ziocha/piezomodel1/README.md

# 27 mm PZT 유니모프 벤더 디스크 CAD 모델

## 파일

| 파일 | 용도 |
| --- | --- |
| `disc_assembly.stl` | 실척 조립 모델. 타일 하우징 설계 시 이 파일을 불러와 간섭 확인 |
| `disc_01_brass.stl` | 황동 백킹판 Ø27.0 × t0.30 |
| `disc_02_ceramic.stl` | PZT 세라믹층 Ø19.7 × t0.22 |
| `disc_03_electrode.stl` | 은 전극 Ø18.5 × t0.02 |
| `disc_04_leads.stl` | 납땜 패드 2개 + 리드선 (각 12 mm만 모델링) |
| `disc_cutaway_x10.stl` | 발표용 반단면 모델. **두께만 10배 과장**했으므로 설계에 쓰면 안 됨 |
| `disc_section_drawing.png` | 보고서용 단면도 |
| `piezo_disc_model.py` | 생성 스크립트. 치수 상수만 바꿔 다시 실행하면 전부 재생성 |

조립 모델 외곽 치수: 37.5 × 27.0 × 1.065 mm (리드선 포함)
디스크 본체만: Ø27.0 × t0.54 mm

## 치수 출처

Murata 7BB-27-4 데이터시트 **공칭값**이다. 실측값이 아니다.

- 외경 27.0 mm / 세라믹 19.7 mm / 총 두께 0.54 mm
- 공진 4.6 ± 0.5 kHz, 정전용량 20 nF ± 30 %

황동판 0.30 mm와 세라믹 0.22 mm의 배분, 전극 두께 0.02 mm는 총 두께에서
역산한 값이므로 오차가 있을 수 있다. 하우징 설계 전에 캘리퍼스로
**외경·세라믹 지름·총 두께 세 가지**를 재서 `piezo_disc_model.py`의
상수를 고친 뒤 다시 생성할 것.

우리 디스크의 실측 공진은 3,332 Hz로 데이터시트보다 약 1 kHz 낮다.
바닥에 놓고 친 지지 조건 차이로 보지만, 소자 자체가 7BB-27-4가 아닐
가능성도 남아 있다. 치수가 위 값과 다르면 그쪽이 원인이다.

## 하우징 설계 시 주의

1. **테두리만 지지할 것.** 유니모프 벤더는 가운데가 휘어야 전하가 난다.
   디스크 전면을 받치면 굽힘이 막혀 출력이 크게 줄어든다.
   하우징에는 Ø27 자리를 파고, 바깥 1~2 mm 링만 닿게 한다.
2. **중앙 공간 확보.** 디스크 아래에 최소 0.5 mm 이상 빈 공간을 둔다.
3. **리드선 통로.** 모델의 리드선은 +x 방향 12 mm만 그려져 있다.
   실물은 70~100 mm이므로 하우징 측면에 Ø1.5 이상 배선 홈이 필요하다.
4. 납땜 패드가 상면에서 1.6 mm 가량 솟아 있다(도면상 고정 높이).
   상판이 이 부분을 누르지 않도록 도피 홈을 판다.

## 재생성

```bash
pip install trimesh manifold3d
python3 piezo_disc_model.py      # STL 6개
python3 section_drawing.py       # 단면도 PNG
```
