ziocha/piezomodel1/README_JIG.md

# 27 mm PZT 디스크 실험 지그

유리프 압전 타일 팀 / 2026-10-21

P–R 곡선 측정과 소자 3종 비교에 필요한 **가압 조건 고정**을 위한 지그다.
손으로 누른 4회의 CV 6.9 %는 잘 나온 쪽이고, 조건당 10회를 다른 날
재면 그 재현성이 유지되지 않는다. 가한 힘의 절대값도 모른다.

## 파일

| 파일 | 내용 |
| --- | --- |
| `jig_01_base.stl` | 하판 44 × 44 × 6 |
| `jig_02_plunger.stl` | 가압 플런저 Ø27 × 24 |
| `jig_03_guide_tube.stl` | 낙하추 가이드관 44 × 44 × 100 |
| `jig_00_assembly_check.stl` | 조립 확인용 (출력하지 말 것) |
| `jig_section_full.png` | 전체 단면도 |
| `jig_section_zoom.png` | 디스크 안착부 확대 단면 |
| `piezo_jig.py` | 생성 스크립트 |

## 설계 의도

**하판** — 포켓 Ø27.4 × 깊이 2.0에 디스크를 넣고, 중앙 Ø22를 관통시켜
비웠다. 디스크는 반경 11~13.7 mm의 링 2.7 mm 폭으로만 지지된다.
유니모프 벤더는 가운데가 휘어야 전하가 나므로 전면 지지는 금물이다.
포켓 바닥 높이에 5 × 1.2 배선 홈이 +x 방향으로 뚫려 있다.

**플런저** — 두 곳이 동시에 닿는다.

- 바깥 링(Ø24~27)이 황동 테두리를 눌러 경계조건을 고정한다
- 중앙 돌기(Ø9)가 세라믹 중앙을 누른다

세라믹이 황동보다 0.24 mm 높으므로 **돌기 바닥이 링 바닥보다 0.24 mm
위에 있다.** 이게 이 부품의 핵심 치수다. FDM 공차(±0.2 mm)와 거의
같은 크기라, 출력 후 두 접촉면이 동시에 닿는지 반드시 확인할 것.
안 닿으면 종이 한 장(약 0.1 mm)으로 조정한다.

링은 +x 쪽이 14 mm 폭으로 끊겨 있다. 황동판 위 납땜 패드(반경 12 mm)를
피하기 위한 슬롯이다. 실물 납땜 위치가 다르면 `R_SOLDER`를 고친다.

**가이드관** — 내경 Ø12.4로 Ø12 추(강봉 또는 M10 너트 적층)를 안내한다.
플랜지 밑면에 Ø28 × 5 도피 공간이 있어 플런저 몸통과 간섭하지 않는다.
옆면 6 mm 슬롯으로 추 위치를 보고 낙하 높이를 맞춘다.
스템 상단이 z ≈ 28 mm, 관 상단이 z ≈ 106 mm이므로 **낙하 높이는 0~77 mm**.

## 조립

1. 하판 포켓에 디스크를 넣고 리드선을 배선 홈으로 뺀다
2. 플런저를 포켓에 얹는다 (고정하지 않는다 — 자중으로만 놓임)
3. 가이드관을 하판 위에 올리고 M3 × 20 볼트 4개로 조인다
4. 추를 관에 넣고 정해진 높이에서 손을 뗀다

## 출력 설정

- 재료 PLA, 레이어 0.2 mm, 인필 40 % 이상
- 하판·플런저는 **포켓 면이 위를 향하게** 놓는다 (접촉면 정밀도 확보)
- 가이드관은 세워서 출력하고 브림을 넣는다
- 서포트: 가이드관 플랜지 도피 공간에만 필요

## 측정할 때

낙하 에너지는 `E = mgh`로 바로 계산되지만(50 g을 50 mm에서 = 25 mJ),
**충돌 피크 힘은 접촉 시간에 좌우되므로 이 지그로는 알 수 없다.**
힘의 절대값이 필요하면 로드셀을 넣어야 한다.

이 지그가 보장하는 것은 **같은 입력을 반복할 수 있다는 것**뿐이다.
그것만으로 부하 저항 변인과 소자 변인 비교는 성립한다. 보고서에는
"가한 힘 F"가 아니라 "낙하 에너지 mgh"를 조작변인으로 적을 것.
