ziocha/piezomodel1/disc_section_drawing.png

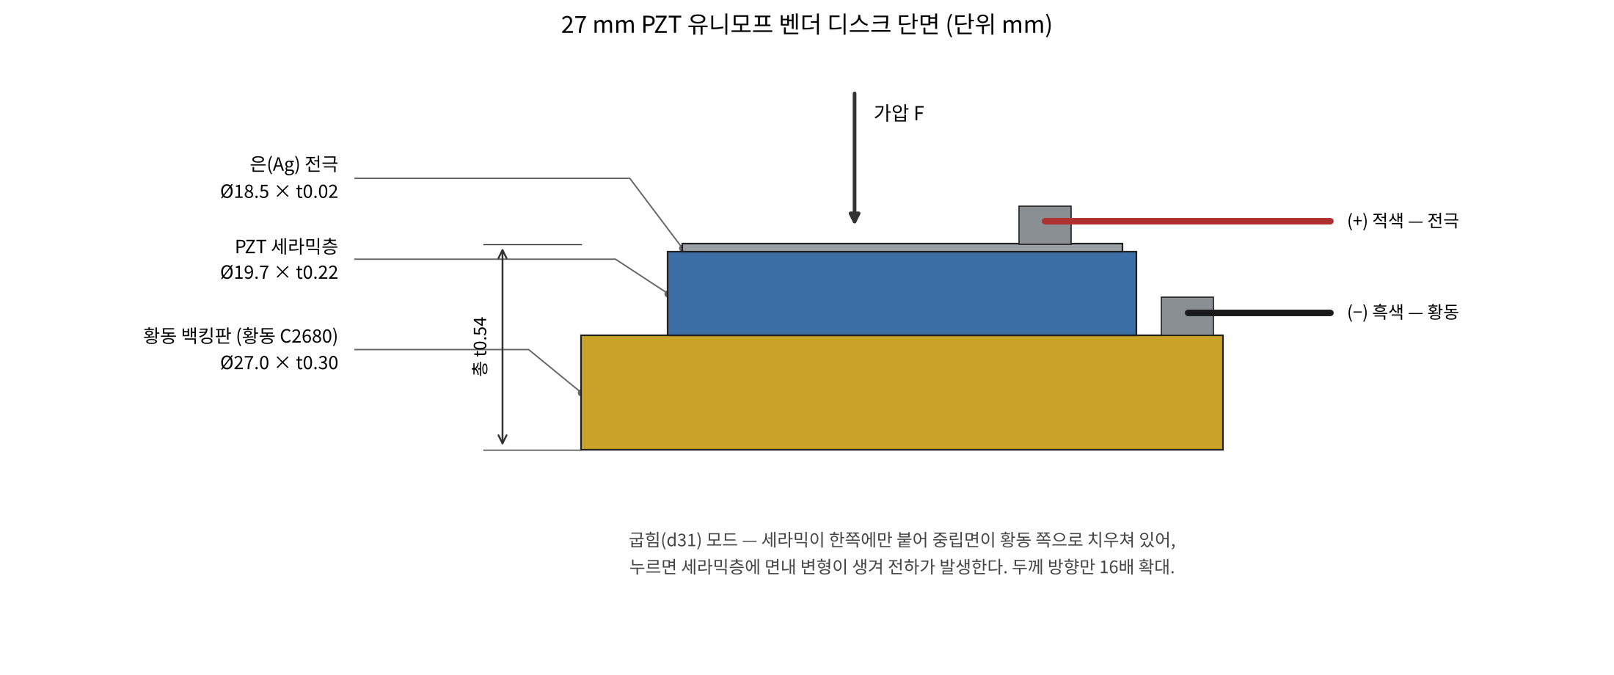
disc_section_drawing.png
