ziocha/piezomodel1/jig2_section.png

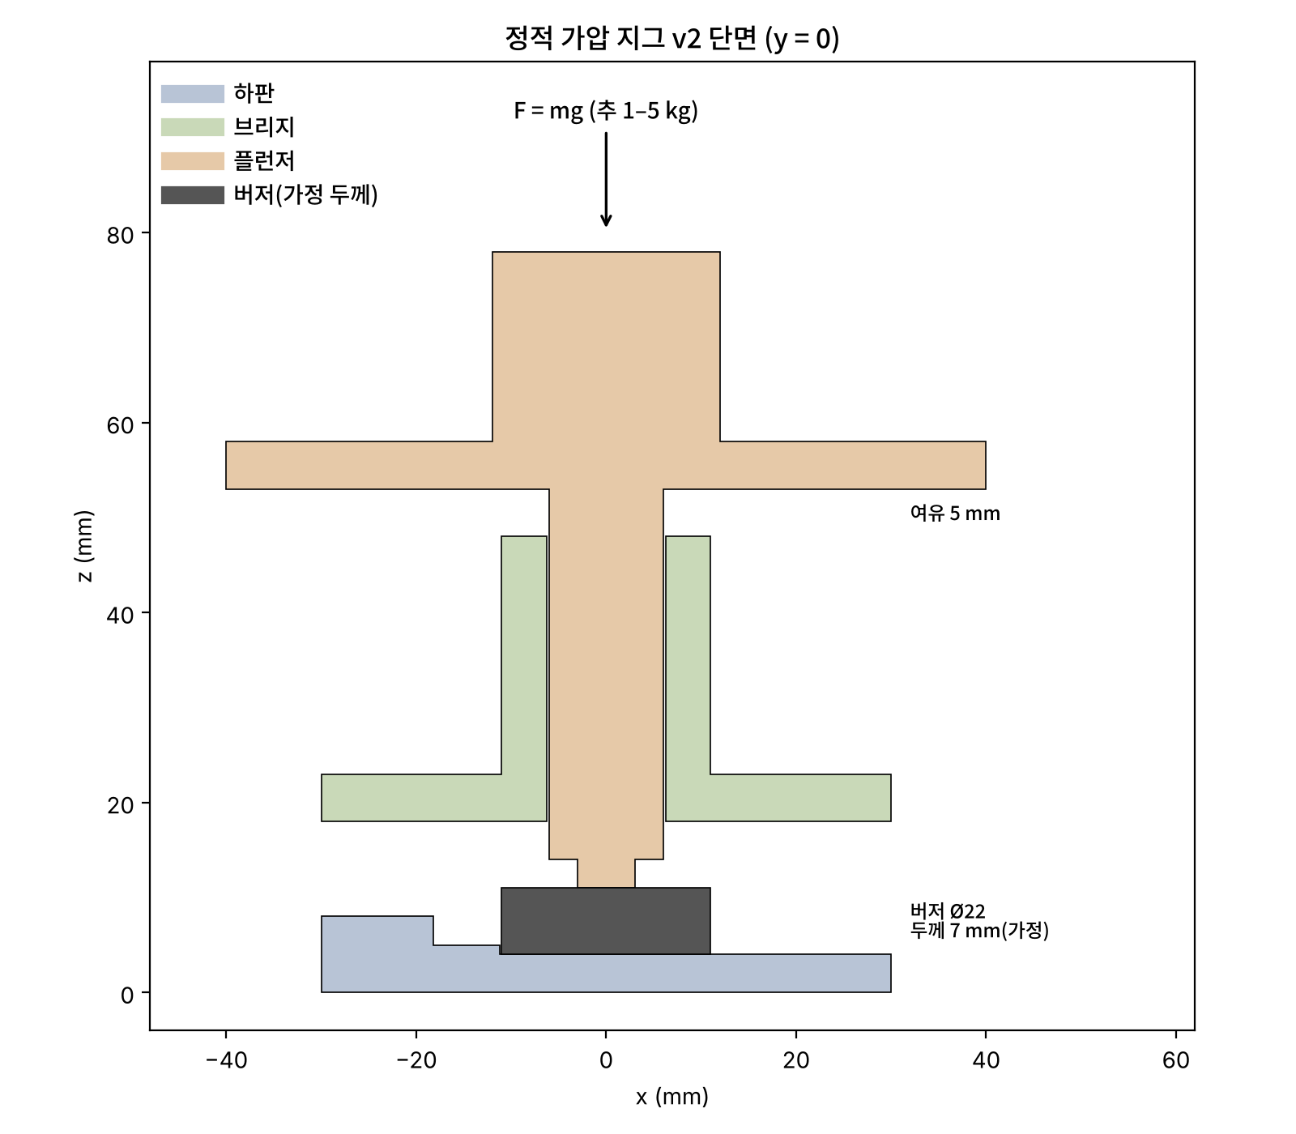
jig2_section.png
