ziocha/piezomodel1/jig_section_full.png

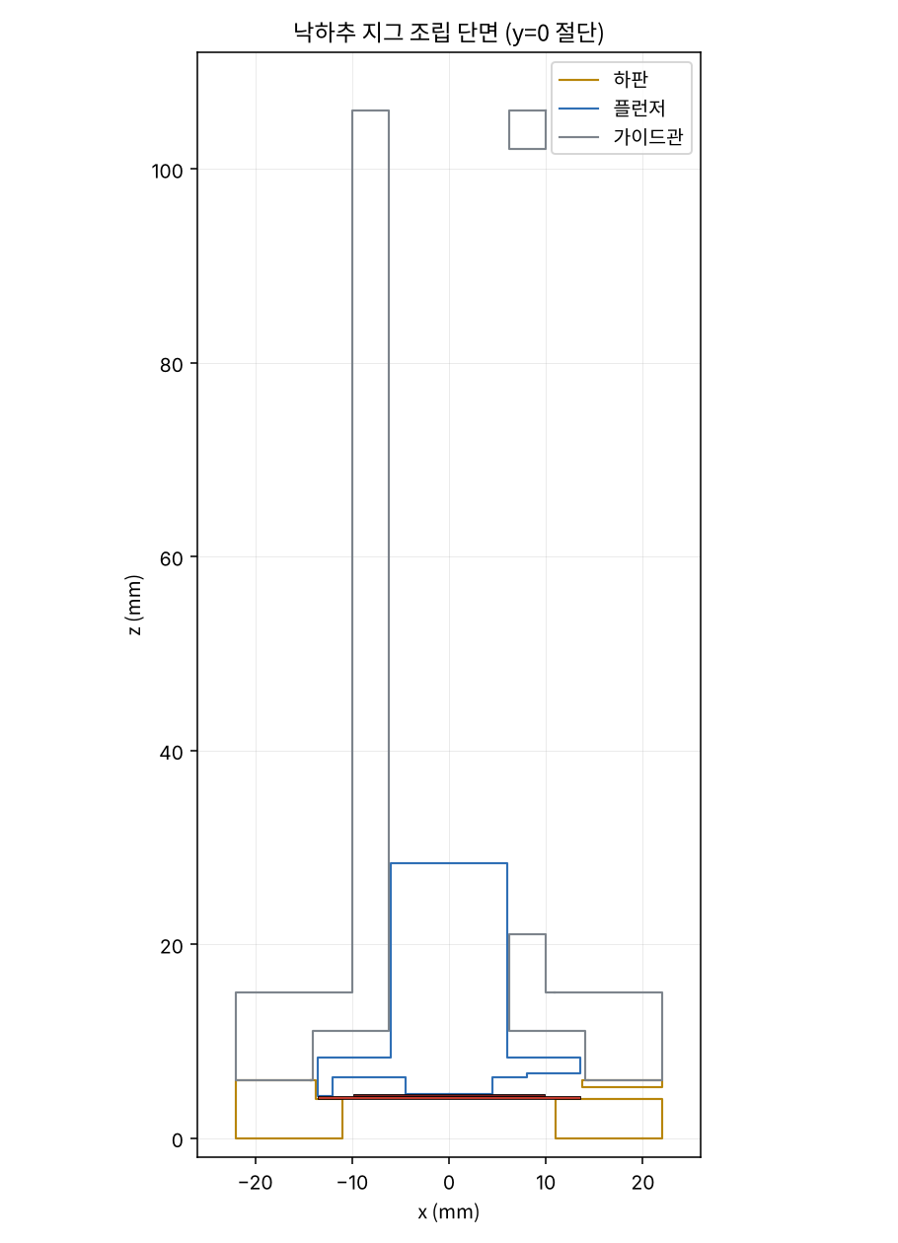
jig_section_full.png
