ziocha/piezomodel1/jig_section_zoom.png

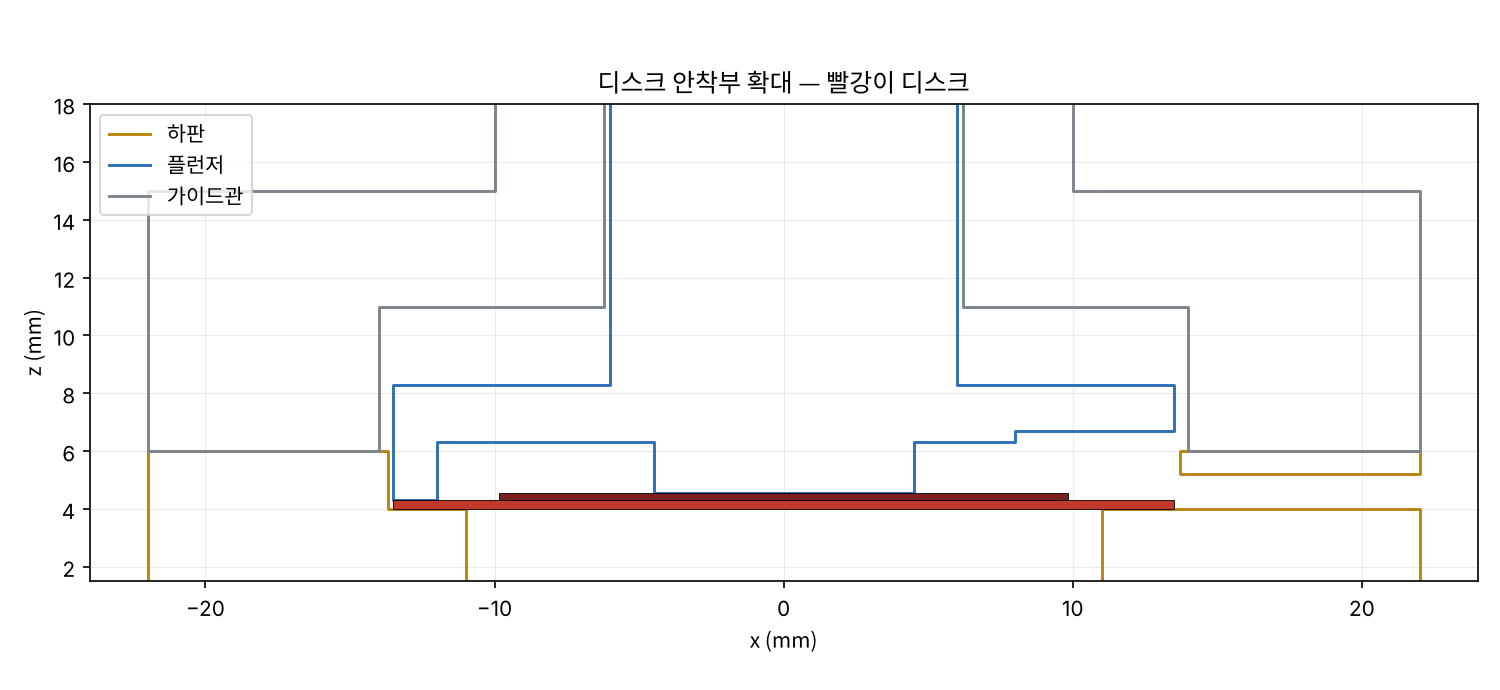
jig_section_zoom.png
