ziocha/piezomodel1/jig2_00_assembly_check.stl

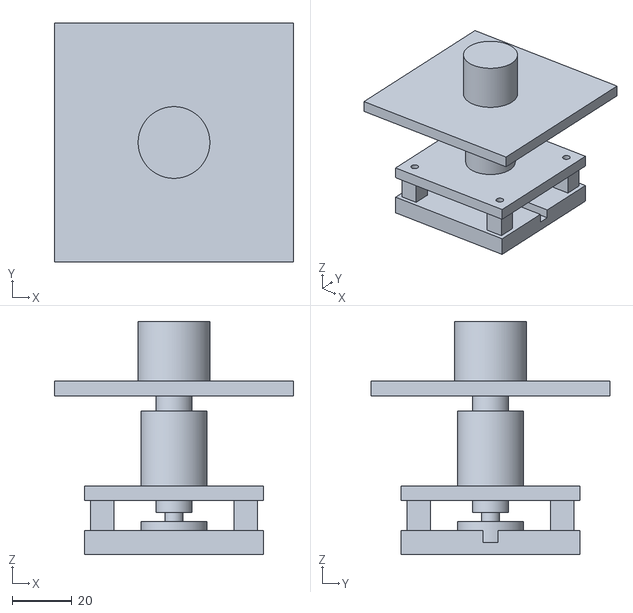
[picture p5: CAD file, 2026-10-28]
jig2_00_assembly_check.stl
80.0 x 80.0 x 78.0
