ziocha/piezomodel1/jig_00_assembly_check.stl

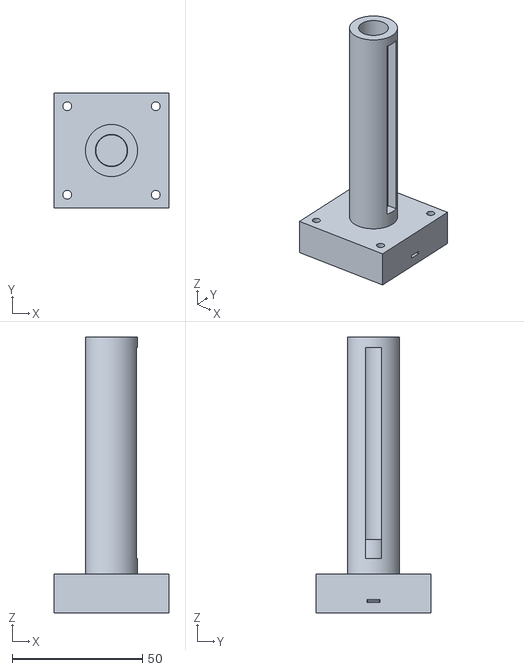
[picture p6: CAD file, 2026-10-21]
jig_00_assembly_check.stl
44.0 x 44.0 x 106.0
