ziocha/piezomodel1/disc_assembly.stl

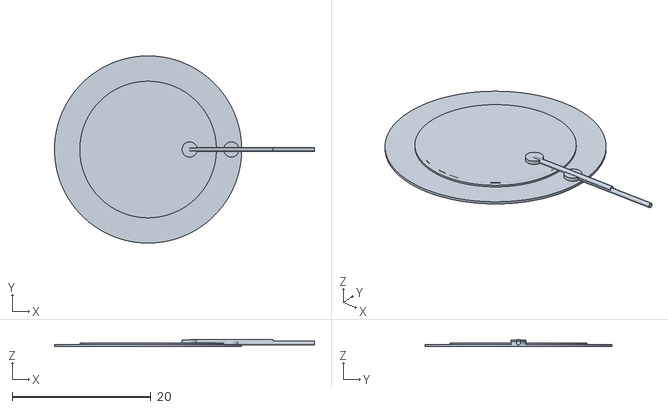
[picture p7: CAD file, 2026-10-21]
disc_assembly.stl
37.5 x 27.0 x 1.07
