ziocha/piezomodel1/jig2_02_bridge.stl

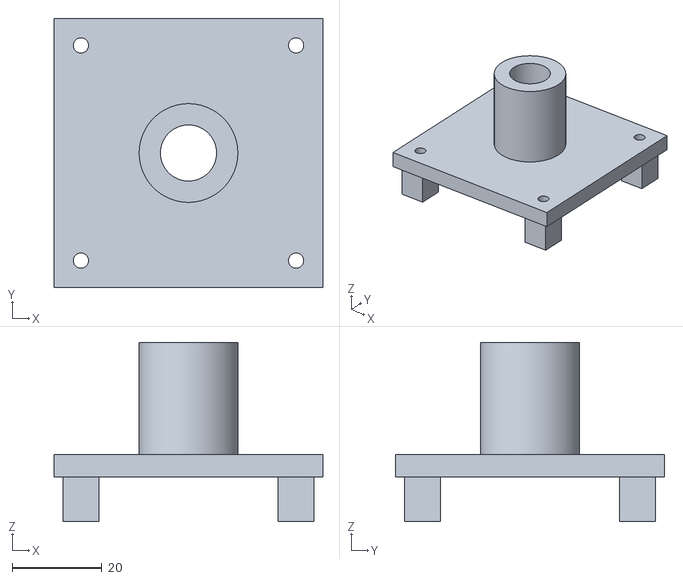
[picture p8: CAD file, 2026-10-28]
jig2_02_bridge.stl
60.0 x 60.0 x 40.0
