ziocha/piezomodel1/jig2_03_plunger.stl

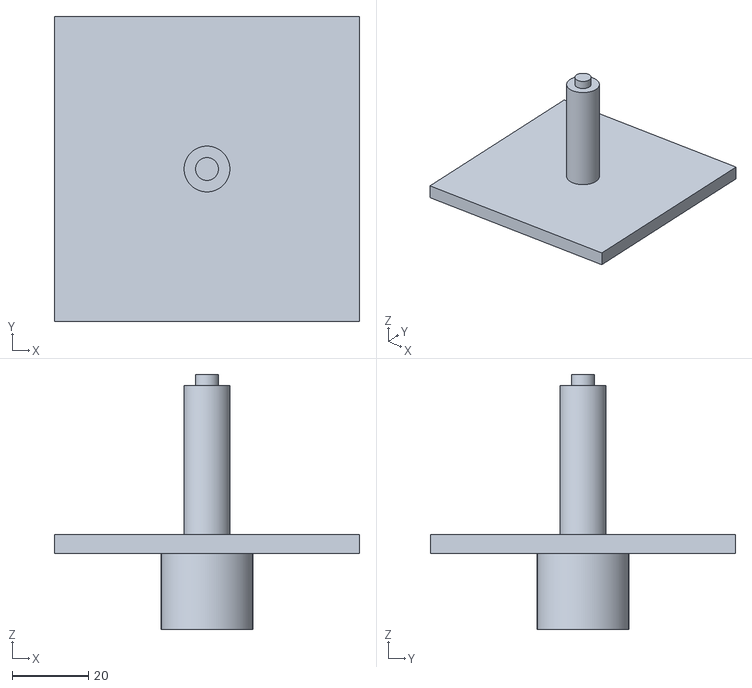
[picture p9: CAD file, 2026-10-28]
jig2_03_plunger.stl
80.0 x 80.0 x 67.0
