ziocha/piezomodel1/jig2_01_base.stl

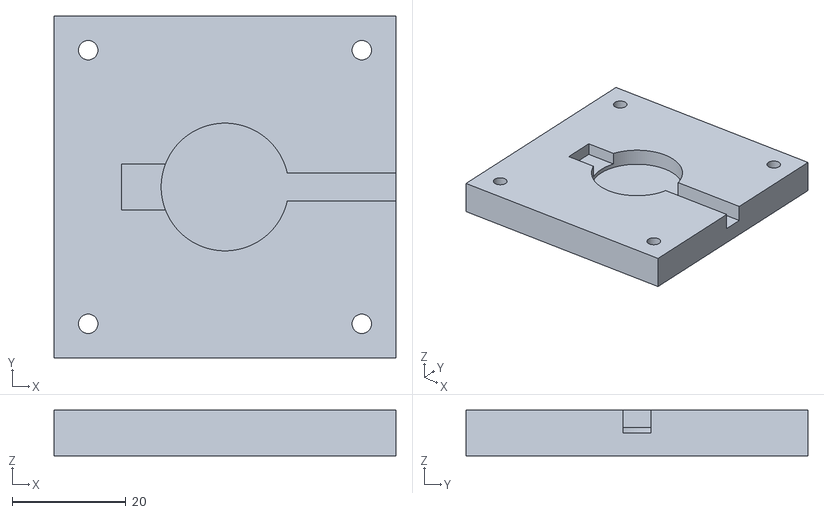
[picture p10: CAD file, 2026-10-28]
jig2_01_base.stl
60.0 x 60.0 x 8.00
