ziocha/piezomodel1/jig_01_base.stl

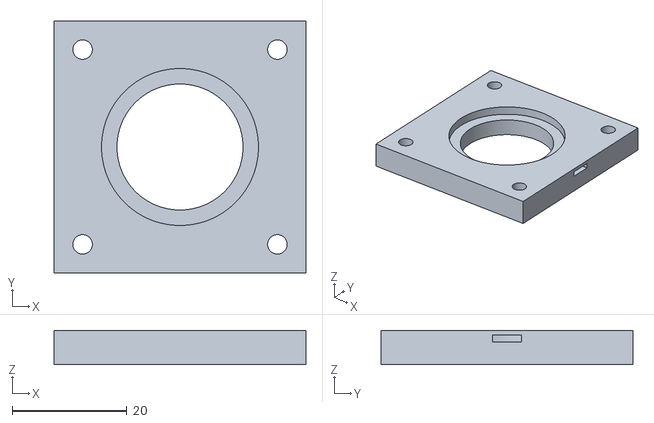
[picture p11: CAD file, 2026-10-21]
jig_01_base.stl
44.0 x 44.0 x 6.00
