ziocha/piezomodel1/jig_02_plunger.stl

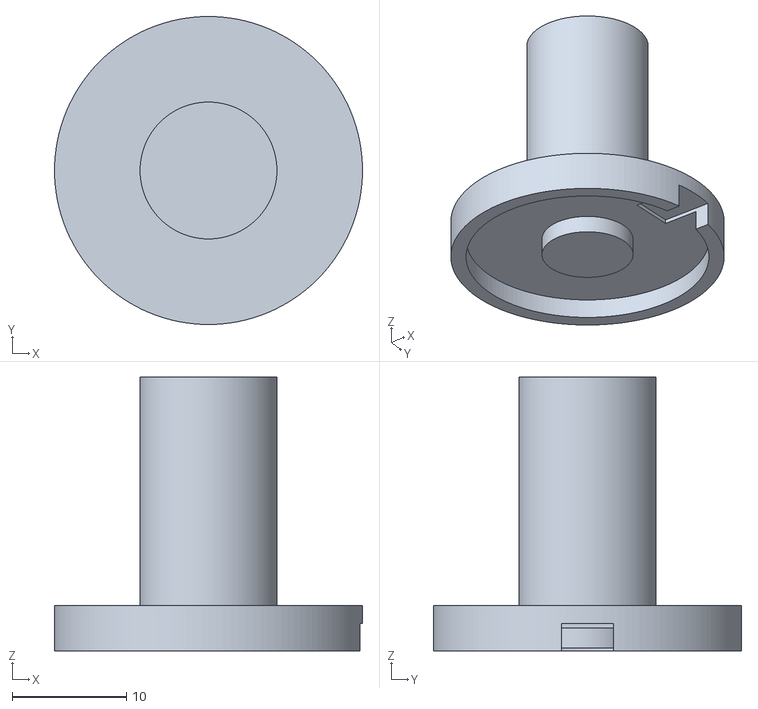
[picture p12: CAD file, 2026-10-21]
jig_02_plunger.stl
27.0 x 27.0 x 24.0
