ziocha/piezomodel1/jig_03_guide_tube.stl

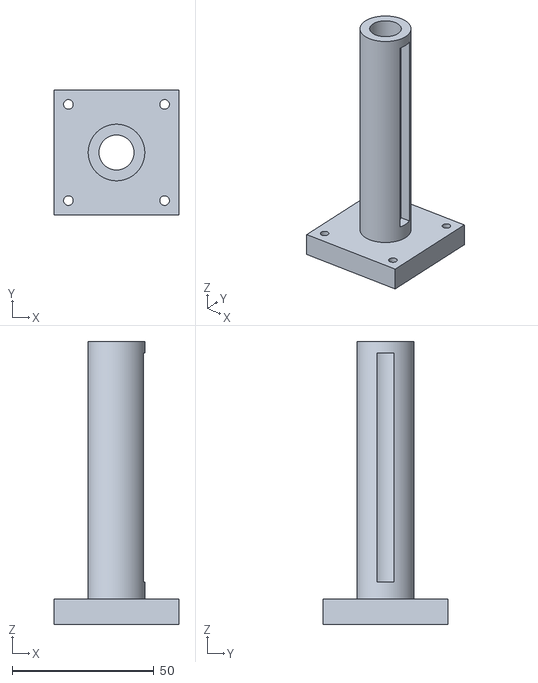
[picture p13: CAD file, 2026-10-21]
jig_03_guide_tube.stl
44.0 x 44.0 x 100.0
