ziocha/piezomodel1/disc_03_electrode.stl

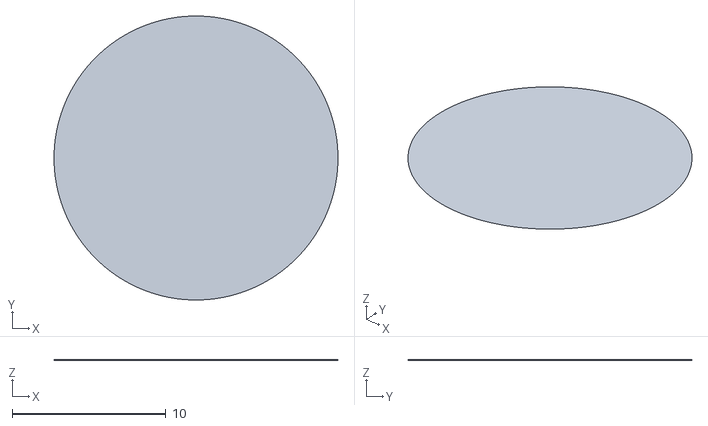
[picture p14: CAD file, 2026-10-21]
disc_03_electrode.stl
18.5 x 18.5 x 0.02
