ziocha/piezomodel1/disc_01_brass.stl

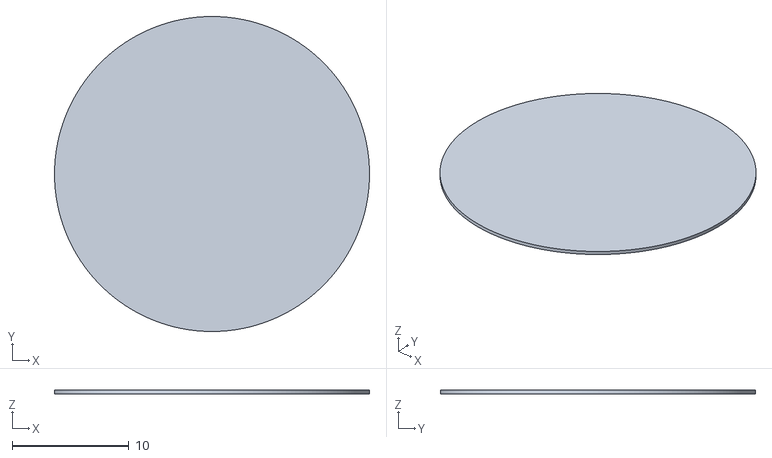
[picture p15: CAD file, 2026-10-21]
disc_01_brass.stl
27.0 x 27.0 x 0.3
