ziocha/piezomodel1/disc_02_ceramic.stl

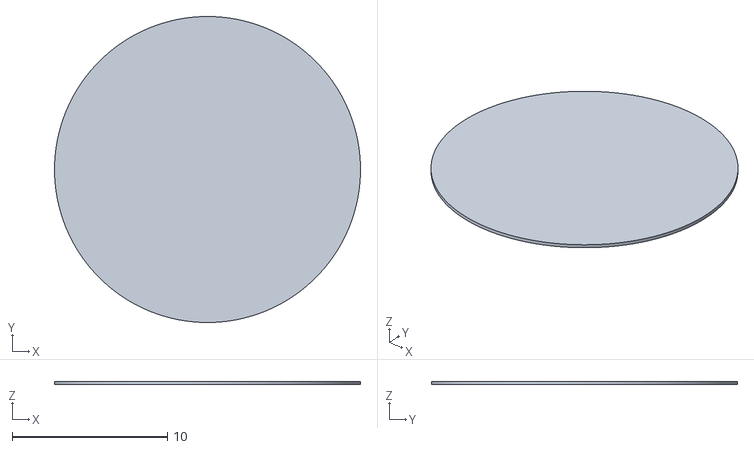
[picture p16: CAD file, 2026-10-21]
disc_02_ceramic.stl
19.7 x 19.7 x 0.22
