ziocha/piezomodel1/disc_04_leads.stl

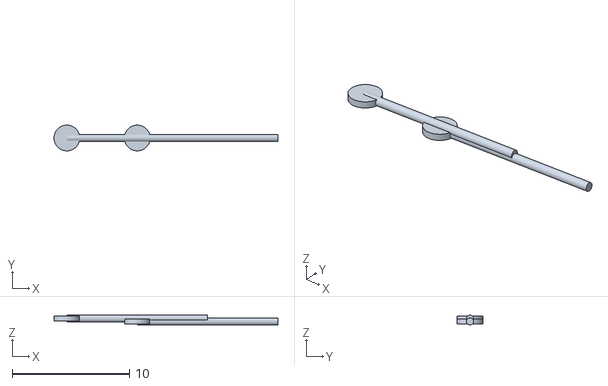
[picture p17: CAD file, 2026-10-21]
disc_04_leads.stl
19.1 x 2.20 x 0.84
