ziocha/piezomodel1/disc_cutaway_x10.stl

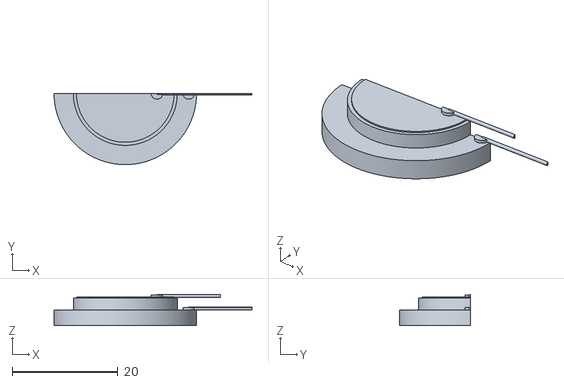
[picture p18: CAD file, 2026-10-21]
disc_cutaway_x10.stl
37.5 x 13.5 x 5.93
